aazibumair/esp32-obd-dashboard/media/preview.jpg

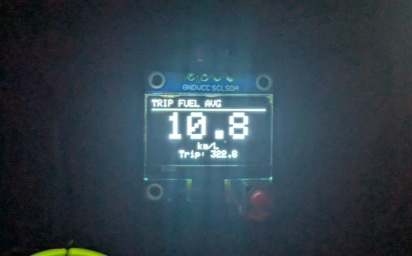
media/preview.jpg
